amerl07/pressure-tap-testing/track_test_results/track_layout.png

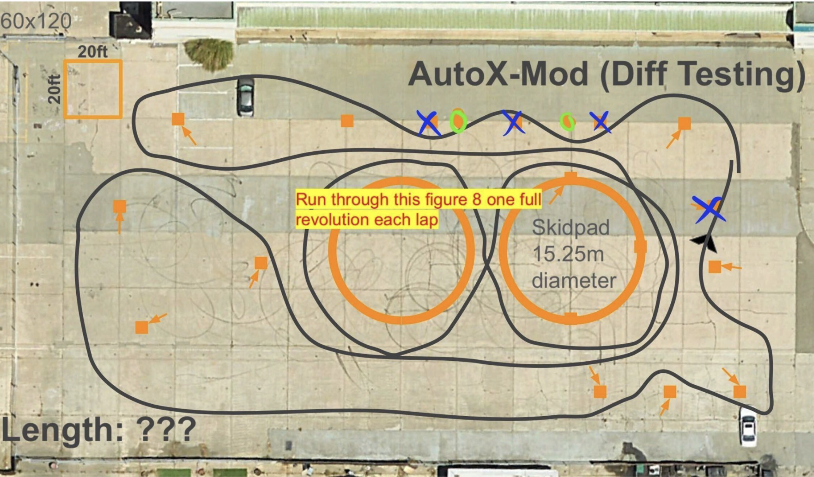
track_test_results/track_layout.png
