amerl07/pressure-tap-testing/perfboard wiring diagram.png

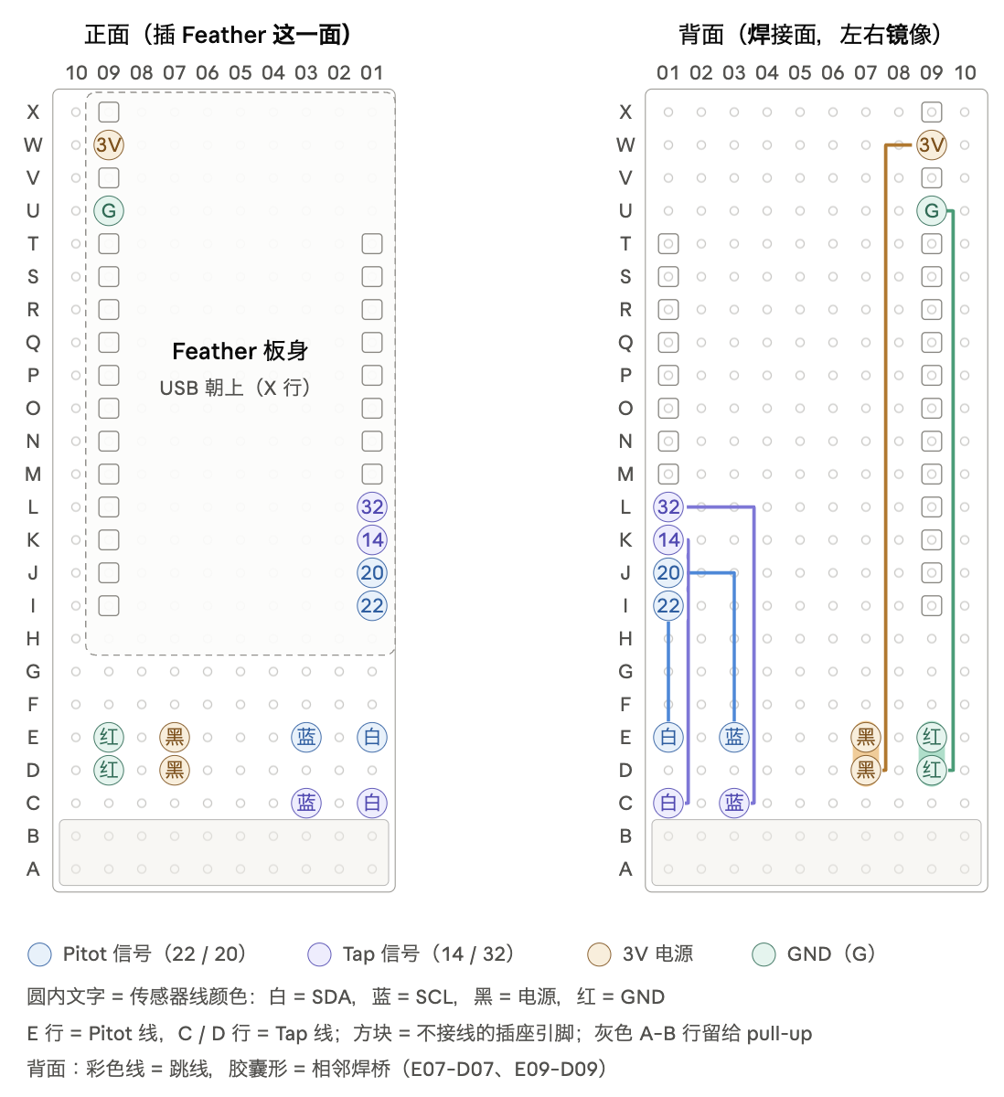
perfboard wiring diagram.png
