amerl07/pressure-tap-testing/track_test_results/Ride Height, Weight Distribution and Alignment - Sheet1.csv

Run | Front RH (in) | Rear RH (in) | Weight Distribution Rear (%) | FL Camber | RL Camber | FR Camber | RR Camber
CAD Baseline | 4.00 | 5.70
Old Squated Config | 4.125 | 4.75 | 51.2
CAD RH run | 4.00 | 5.70 | 50.90 | -1.40 | -1.00 | -1.50 | 0.30
Squat Down | 4.00 | 5.25 | 50.90 | -0.50 | 0.30 | -1.20 | -0.90
