amerl07/pressure-tap-testing/track_test_results/compare_runs_laps.csv

Run | lap | note | isHot | Cp_slope | Intercept_Pa | Cp_qweighted | Vmean_ms
Block 1 CAD RH | 1 | Outlap 1 (Stationary) | 0 | -2.04644907150934 | 1.83675789811996 | -2.02834644423751 | 9.69000116671951
Block 1 CAD RH | 2 | Outlap 2 | 0 | -2.12358856656214 | 13.7749893822647 | -1.95878083102196 | 11.2199248608796
Block 1 CAD RH | 3 | Hotlap | 1 | -1.76733567631281 | -10.0333763197822 | -1.84741732083989 | 11.4542838154202
Block 1 CAD RH | 4 | Hotlap | 1 | -2.07371478103861 | 13.2213668523118 | -1.92676725671103 | 11.9310816491928
Block 1 CAD RH | 5 | Hotlap | 1 | -1.97283262585674 | 9.09905344657113 | -1.83893614063613 | 11.654476645106
Block 1 CAD RH | 6 | Hotlap | 1 | -1.8169509540332 | -16.1418956850926 | -1.96564790019249 | 11.3581052917
Block 1 CAD RH | 7 | Hotlap | 1 | -1.93121339101992 | 0.151060162129679 | -1.92595194876055 | 11.6876733124079
Block 1 CAD RH | 8 | Hotlap | 1 | -2.20362118983053 | 20.8139195559692 | -1.97855767686132 | 11.7477685535943
Block 1 CAD RH | 9 | Hotlap | 1 | -2.11398733482008 | 8.55971070606516 | -2.00973022464002 | 11.3155713435021
Block 1 CAD RH | 10 | Hotlap | 1 | -1.99093375397412 | 9.97483830312338 | -1.87412359459147 | 11.590019220558
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
