amerl07/pressure-tap-testing/track_test_results/esp32_lap_index.csv

setting | esp_file | lap | note | lap_start_s | lap_end_s | esp_start_ms | esp_end_ms | row_start | row_end | wall_start | wall_end | r_vs_template
CAD Ride Height | 1107_1745/run000.csv | 1 | Outlap 1 (Stationary) |  | 25.43 | 435000 | 460430 | 218 | 455 | 17:30:08 | 17:30:33 | 0.12
CAD Ride Height | 1107_1745/run000.csv | 2 | Outlap 2 | 25.43 | 63.47 | 460430 | 498470 | 456 | 810 | 17:30:33 | 17:31:11 | 0.94
CAD Ride Height | 1107_1745/run000.csv | 3 | Hotlap | 63.47 | 100.53 | 498470 | 535530 | 811 | 1155 | 17:31:11 | 17:31:48 | 0.99
CAD Ride Height | 1107_1745/run000.csv | 4 | Hotlap | 100.53 | 137.47 | 535530 | 572470 | 1156 | 1501 | 17:31:48 | 17:32:25 | 0.98
CAD Ride Height | 1107_1745/run000.csv | 5 | Hotlap | 137.47 | 174.57 | 572470 | 609570 | 1502 | 1848 | 17:32:25 | 17:33:02 | 0.97
CAD Ride Height | 1107_1745/run000.csv | 6 | Hotlap | 174.57 | 211.87 | 609570 | 646870 | 1849 | 2197 | 17:33:02 | 17:33:39 | 0.96
CAD Ride Height | 1107_1745/run000.csv | 7 | Hotlap | 211.87 | 248.37 | 646870 | 683370 | 2198 | 2538 | 17:33:39 | 17:34:16 | 0.99
CAD Ride Height | 1107_1745/run000.csv | 8 | Hotlap | 248.37 | 285.1 | 683370 | 720100 | 2539 | 2881 | 17:34:16 | 17:34:53 | 0.99
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
