amerl07/pressure-tap-testing/track_test_results/laptimes.csv

 | Resolution: 1/30s |  |  |  | Note | Cooldown Lap Not Included
Setting | Lap No. | Start Time (s) | Finish Time (s) | Lap Time (s)
CAD Ride Height | 1 | Not recorded | 25.43 | - | Outlap 1 (Stationary)
CAD Ride Height | 2 | 25.43 | 63.47 | 38.03 | Outlap 2
CAD Ride Height | 3 | 63.47 | 100.53 | 37.07 | Hotlap
CAD Ride Height | 4 | 100.53 | 137.47 | 36.93 | Hotlap
CAD Ride Height | 5 | 137.47 | 174.57 | 37.10 | Hotlap
CAD Ride Height | 6 | 174.57 | 211.87 | 37.30 | Hotlap
CAD Ride Height | 7 | 211.87 | 248.37 | 36.50 | Hotlap
CAD Ride Height | 8 | 248.37 | 285.10 | 36.73 | Hotlap
CAD Ride Height | 9 | 285.10 | 322.20 | 37.10 | Hotlap
CAD Ride Height | 10 | 322.20 | 359.33 | 37.13 | Hotlap
AVG |  |  |  | 36.98
Squat Down | 1 | 22.33 | 60.23 | 37.90 | Outlap 1 (Stationary)
Squat Down | 2 | 60.23 | 97.97 | 37.73 | Outlap 2
Squat Down | 3 | 97.97 | 134.67 | 36.70 | Hotlap
Squat Down | 4 | 134.67 | 161.93 | 27.27 | Did not do complete figure 8
Squat Down | 5 | 161.93 | 198.23 | 36.30 | Hotlap
Squat Down | 6 | 198.23 | 237.10 | 38.87 | Power cut in figure 8
Squat Down | 7 | 237.10 | 276.60 | 39.50 | Power cut in figure 8
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
