amerl07/pressure-tap-testing/track_test_results/processed_results_package/data/hotlap_summary.csv

Run | n_hotlaps | Cp_qweighted_mean | Cp_qweighted_std | Cp_slope_mean | Cp_slope_std | Vmean_ms
Block 1 CAD RH | 8 | -1.92089150790411 | 0.0627732289097094 | -1.98382371336075 | 0.146865679036258 | 11.5923724789352
Block 2 Squat Down | 8 | -2.03639182643281 | 0.0668261846767992 | -2.08277583672998 | 0.162830373909213 | 10.9098130084096
