amerl07/pressure-tap-testing/track_test_results/compare_runs_summary.csv

Run | Lag_ms | Cp_slope | Intercept_Pa | r | Cp_qweighted | Vmax_ms | Cp_5_8 | Cp_8_10 | Cp_10_12 | Cp_12_14 | Cp_14_16 | Cp_16_18 | Cp_18_20
Block 0a warm-up | 202 | -1.54782131875466 | -24.1041451456779 | 0.882133470830921 | -1.83883992077414 | 16.7566634570438 | -2.17171374748562 | -2.08481827242725 | -1.89071017280143 | -1.7744209541305 | -1.82318034079839 | -1.61356084387926 | NaN
Block 0b run00 warm-up | 101 | -1.51796708465426 | -21.4679855475142 | 0.892445958716203 | -1.76809283278549 | 17.5759377374352 | -2.11201057098798 | -1.77315497418276 | -1.79310951529897 | -1.87264467149914 | -1.77257766484188 | -1.34453112288268 | NaN
Block 0b run01 warm-up | 101 | -1.6925629118255 | -13.6658858733886 | 0.88804559006111 | -1.84270558078884 | 17.5155069628329 | -2.14007575723076 | -1.96679500219828 | -1.88331203907624 | -1.81804367462549 | -1.76404674378047 | -1.83445426094753 | NaN
Block 1 CAD RH | 101 | -1.9810917678118 | 2.61239065271439 | 0.913168132285473 | -1.94238402762306 | 17.3903451933341 | -2.30156165308906 | -1.89296264159443 | -1.91094516417771 | -1.99962994739683 | -1.9700671228771 | -1.91187276785517 | NaN
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
