amerl07/pressure-tap-testing/track_test_results/esp32_lap_alignment.png

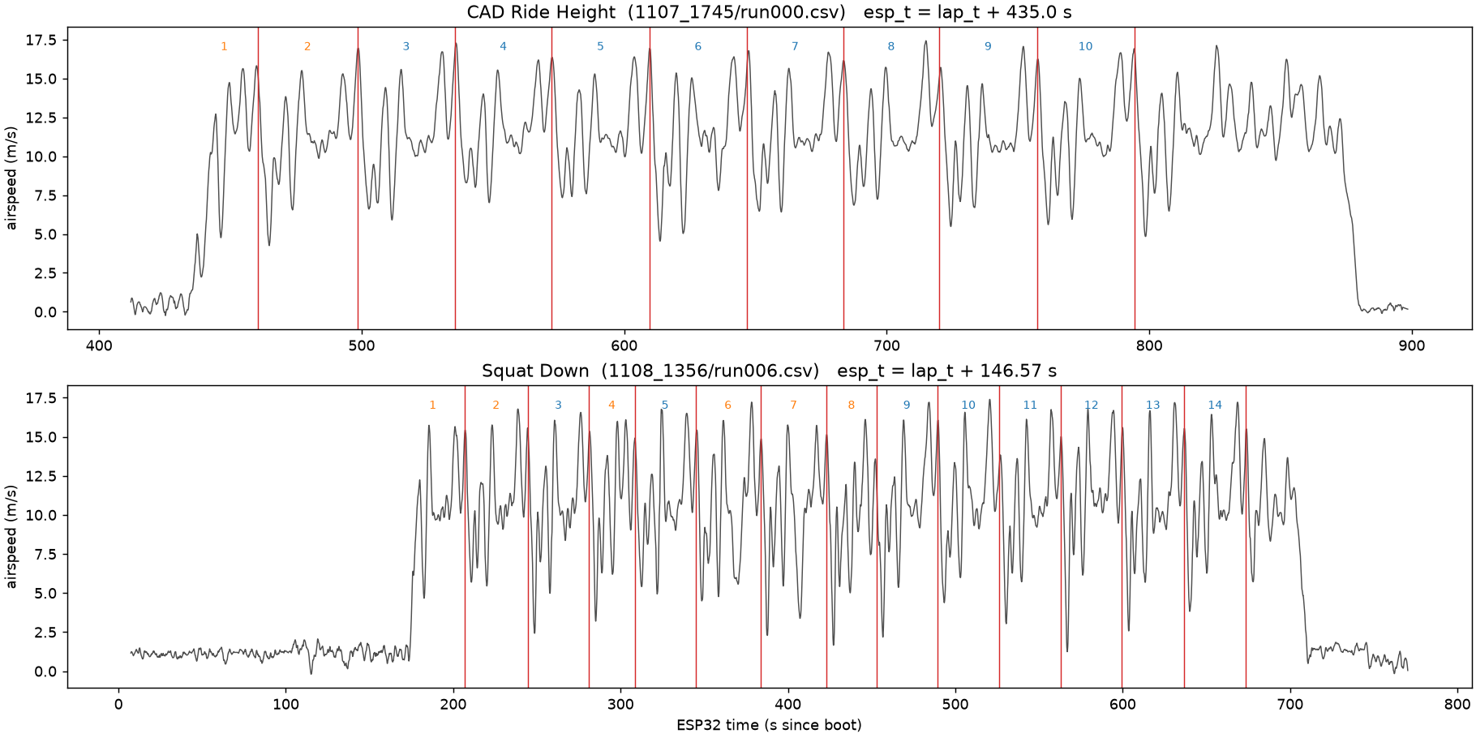
track_test_results/esp32_lap_alignment.png
