amerl07/pressure-tap-testing/track_test_results/processed_results_package/plots/1_per_lap_cp.png

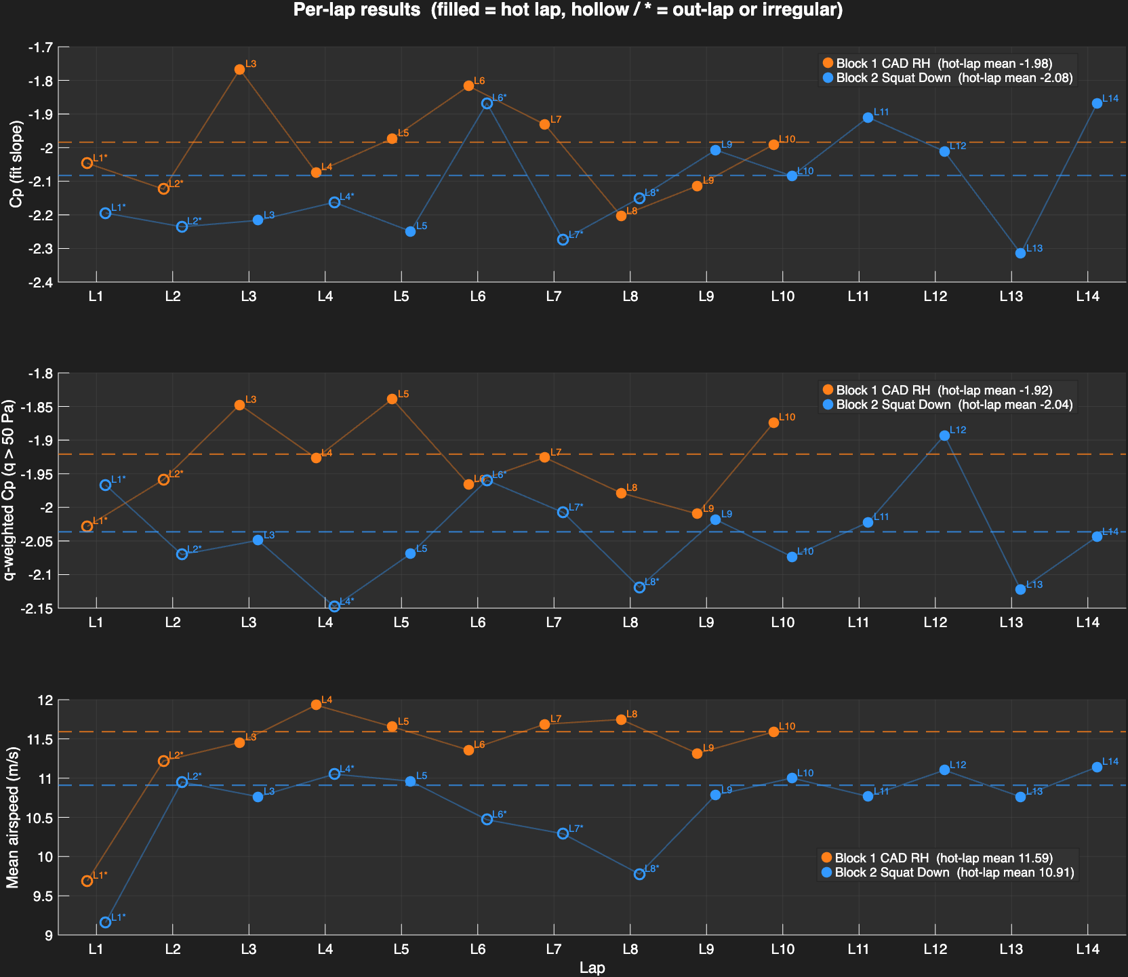
track_test_results/processed_results_package/plots/1_per_lap_cp.png
