amerl07/pressure-tap-testing/track_test_results/processed_results_package/plots/2_tap_vs_q.png

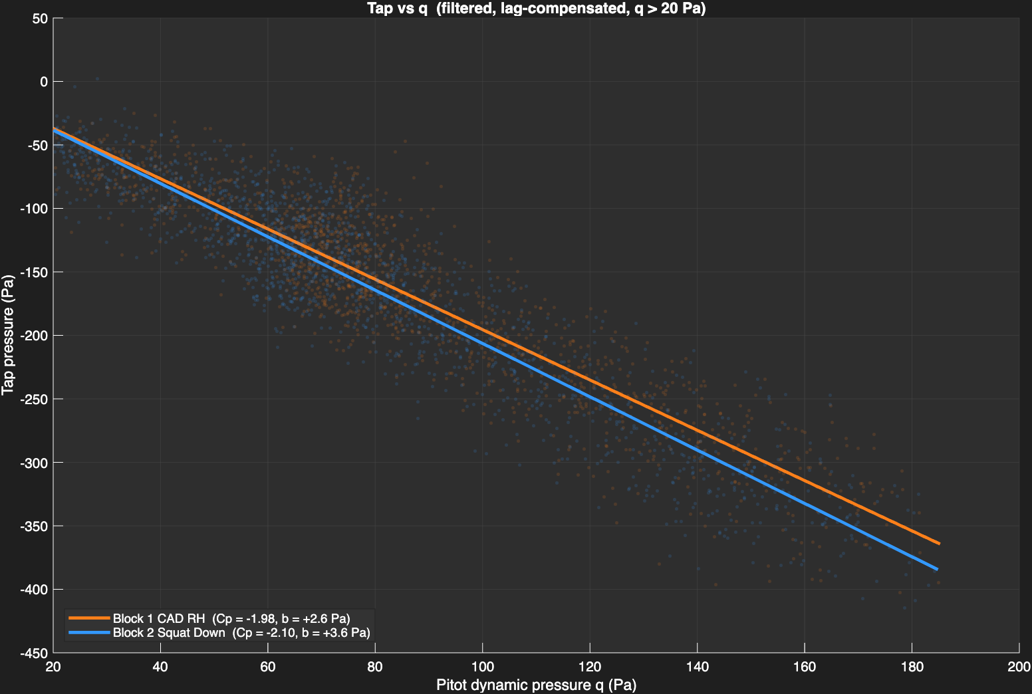
track_test_results/processed_results_package/plots/2_tap_vs_q.png
