amerl07/pressure-tap-testing/track_test_results/processed_results_package/plots/3_cp_by_speed_band.png

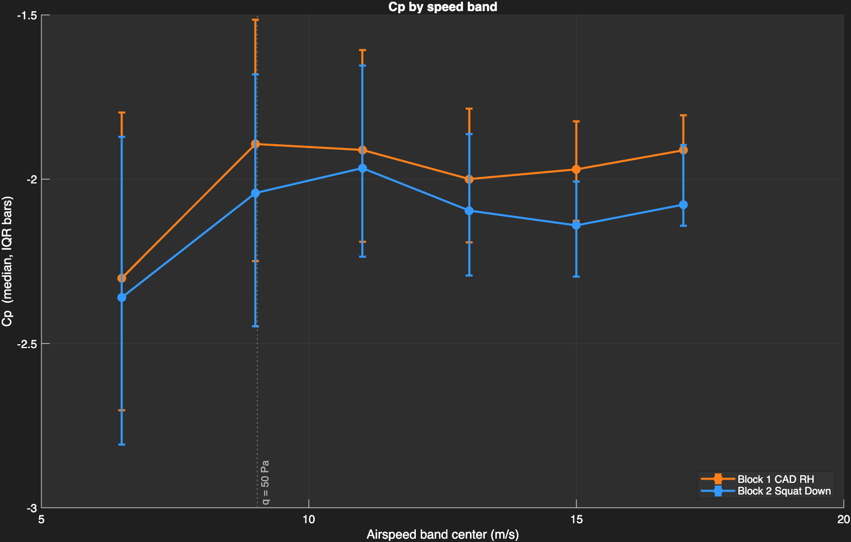
track_test_results/processed_results_package/plots/3_cp_by_speed_band.png
