amerl07/pressure-tap-testing/track_test_results/processed_results_package/plots/4_timeseries_block1_CAD_RH.png

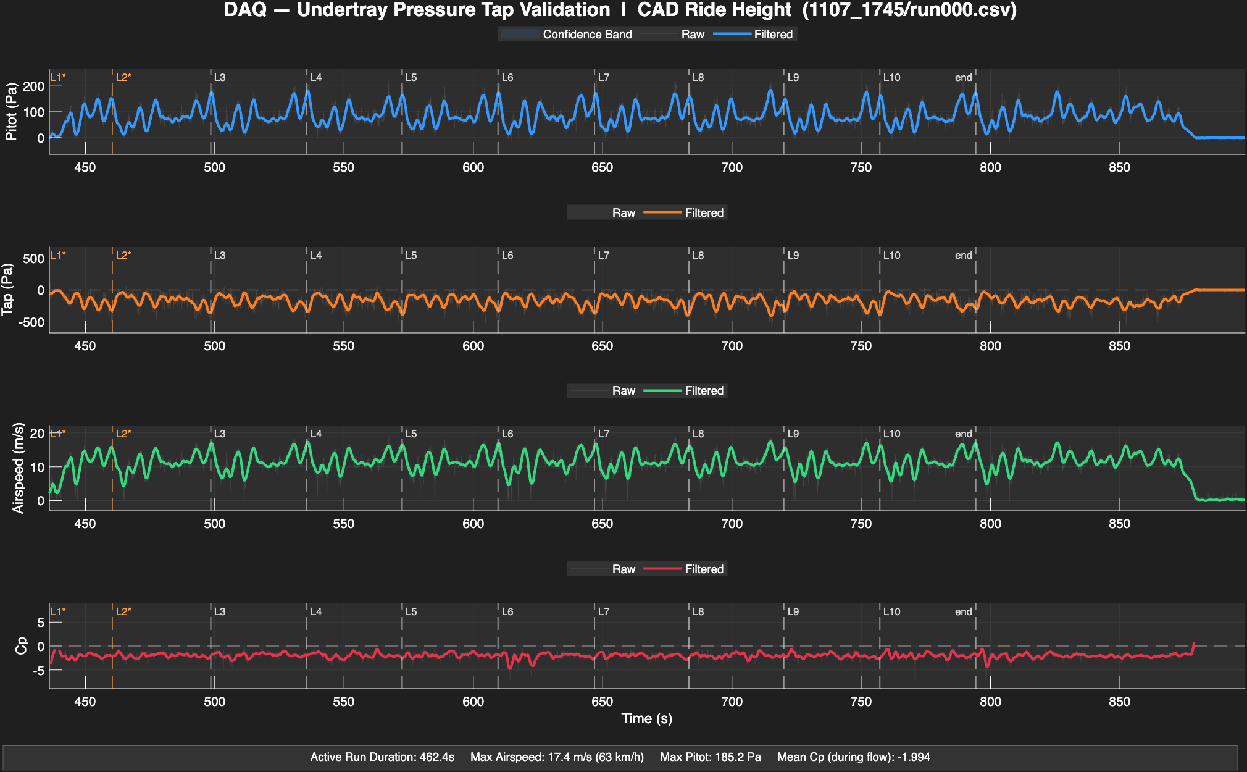
track_test_results/processed_results_package/plots/4_timeseries_block1_CAD_RH.png
