amerl07/pressure-tap-testing/track_test_results/processed_results_package/plots/5_timeseries_block2_squat_down.png

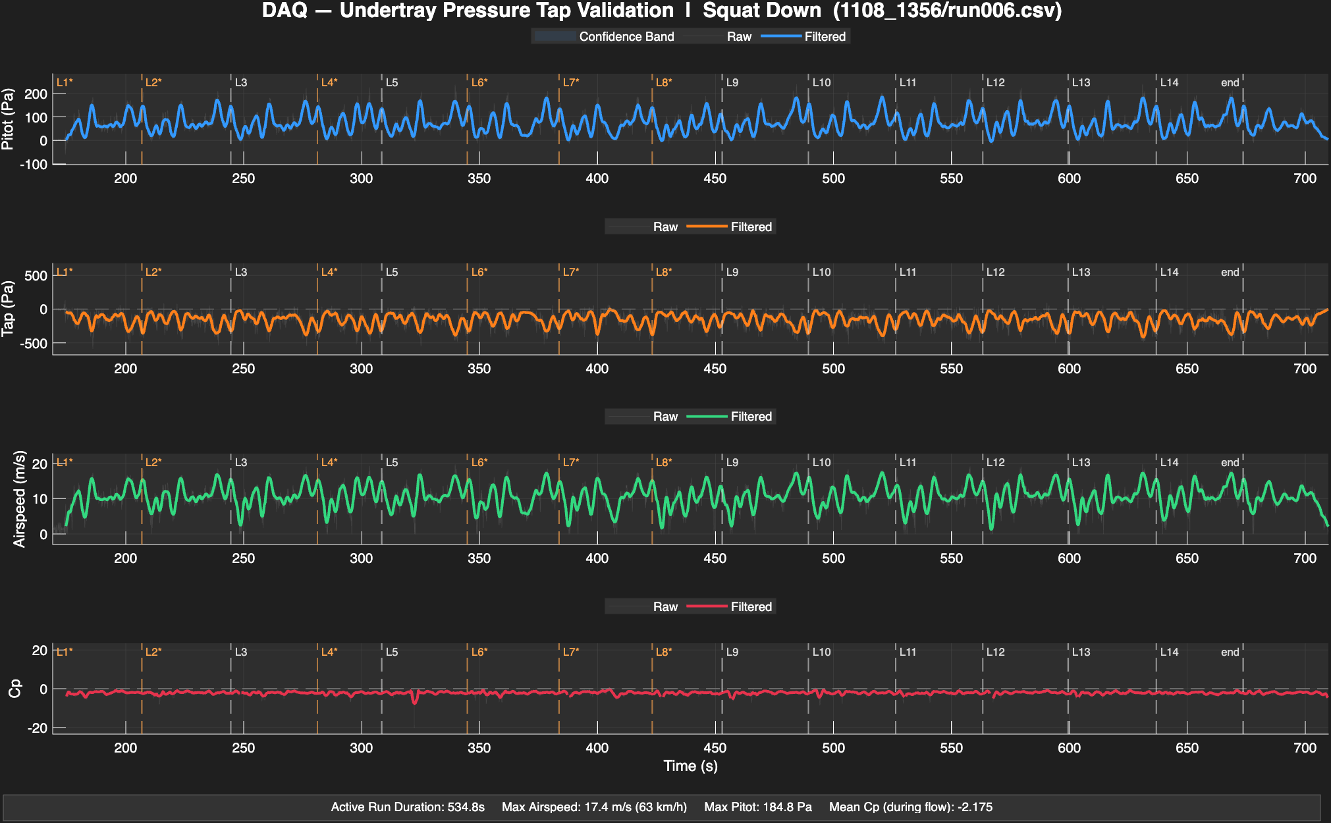
track_test_results/processed_results_package/plots/5_timeseries_block2_squat_down.png
