amerl07/pressure-tap-testing/track_test_results/processed_results_package/plots/6_pitot_block1_vs_block2.png

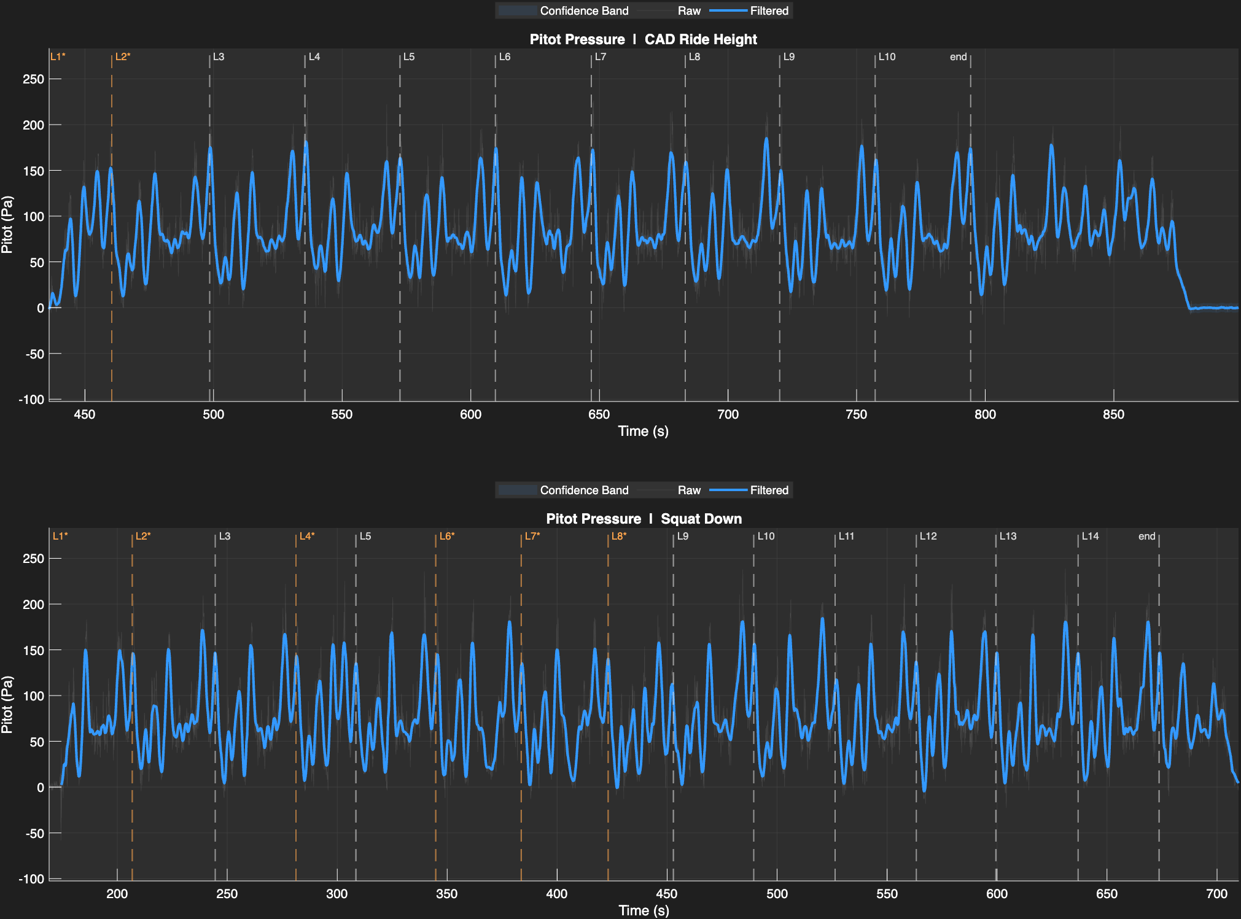
track_test_results/processed_results_package/plots/6_pitot_block1_vs_block2.png
