amerl07/pressure-tap-testing/track_test_results/processed_results_package/plots/9_pitot_overlay.png

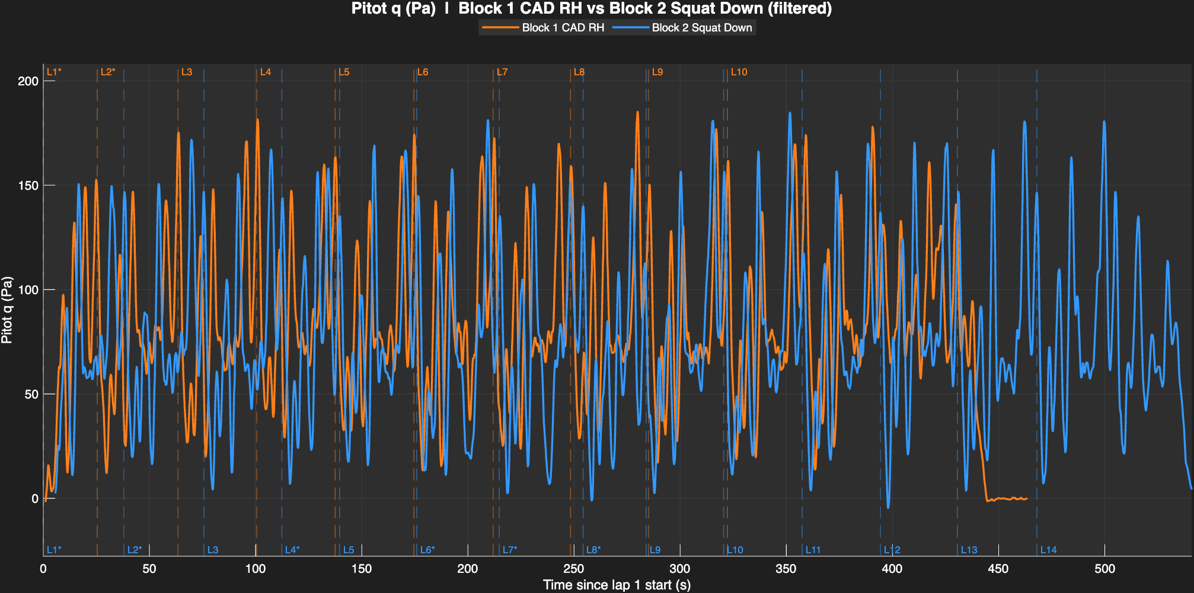
track_test_results/processed_results_package/plots/9_pitot_overlay.png
