amerl07/pressure-tap-testing/track_test_results/processed_results_package/plots/10_tap_overlay.png

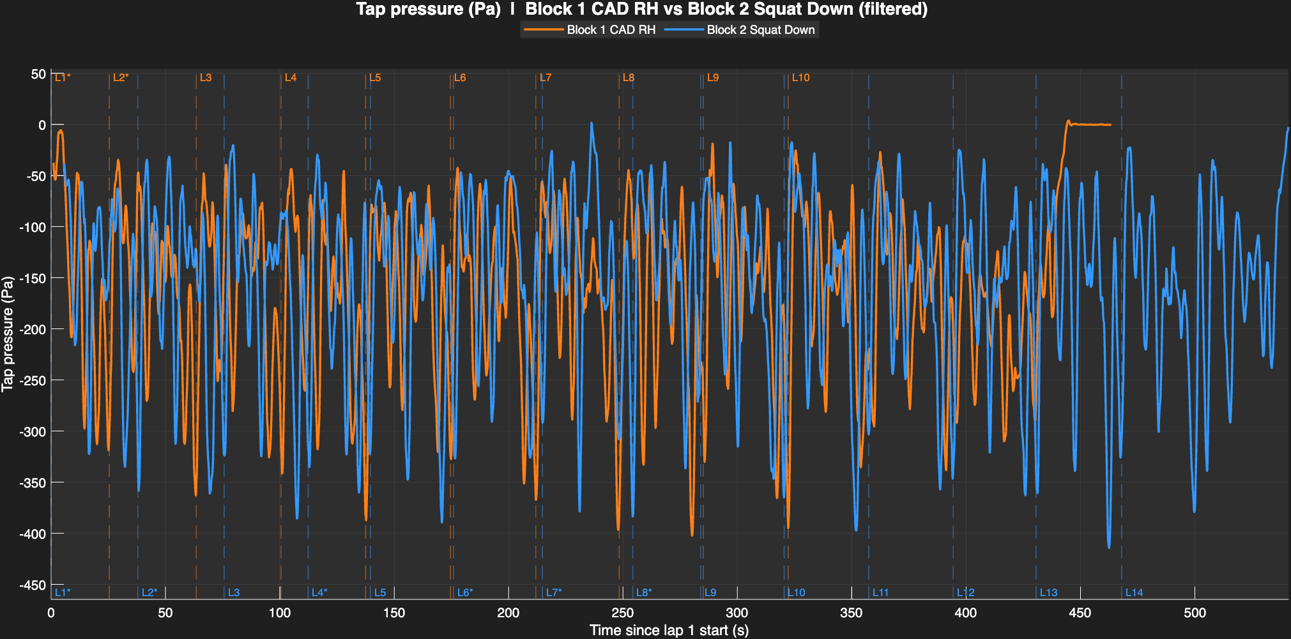
track_test_results/processed_results_package/plots/10_tap_overlay.png
