amerl07/pressure-tap-testing/(commit log)

2026-09-12 Added TODO for pressure tap mounting
2026-11-07 files for Nov 7 alameda testing
    [run000.csv]
2026-11-07 Updated testing materials for nov 7 alameda
2026-11-07 Enhance README with detailed setup and wiring instructions
    Expanded the setup guide for the pressure tap logger to include details on hardware versions, wiring instructions, and calibration fixes. Updated sections on powering the board, Arduino IDE setup, and data retrieval processes.
2026-11-11 Add Nov 7-8 Alameda track test analysis and results package
    - Lap alignment of laptimes.csv onto ESP32 logs (align_laps.py, LAP_ALIGNMENT.md)
    - Per-lap Cp, tap-vs-q regression and speed-band analysis (compare_runs.m)
    - Lap dividers, lap-1 trimming and outside legends in PressureDataPlots.m
    - Results package for VD: plots, processed data, README (make_results_package.m)
    - Raw ESP32 logs, test notes, lap times and car setup sheet
    - README rewritten as a repo index; setup guide moved to HARDWARE_SETUP.md
    - Project doc renamed to PROJECT_OVERVIEW.md, updated with status and derivations
    - .gitignore for OS junk, generated zip and large car telemetry exports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
    [Ride Height, Weight Distribution and Alignment - Sheet1.csv, block_1_cad_rh__1107_1745_run000.csv, block_2_squat_down__1108_1356_run006.csv, car_setup.csv, compare_runs_laps.csv, compare_runs_summary.csv, esp32_lap_index.csv, hotlap_summary.csv]
